Metori/mqtt_domofon/doc/mqtt_domofon_work_flow.jpg

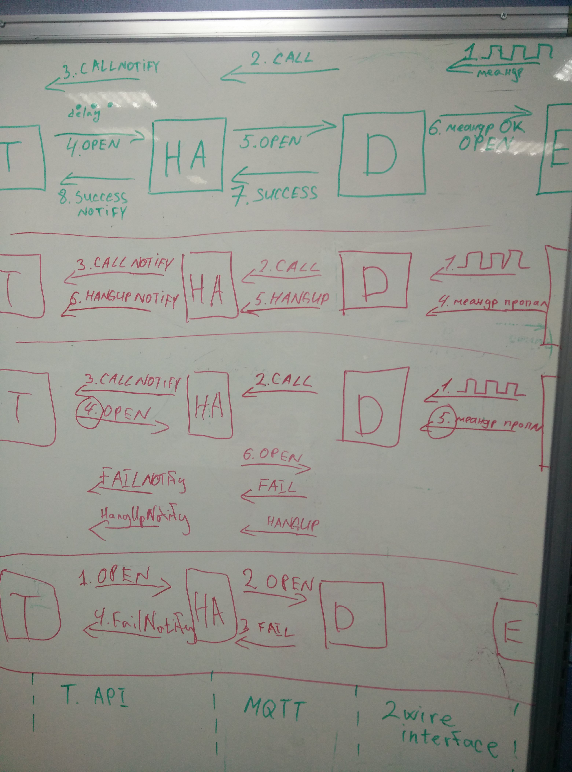
doc/mqtt_domofon_work_flow.jpg
