Metori/mqtt_domofon/doc/mqtt_domofon_complete_device.jpg

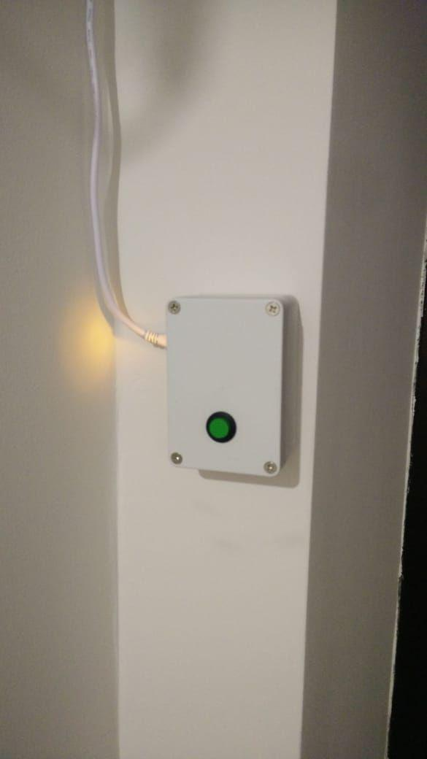
doc/mqtt_domofon_complete_device.jpg
