Metori/mqtt_domofon/doc/mqtt_domofon_circuit_diagram.jpg

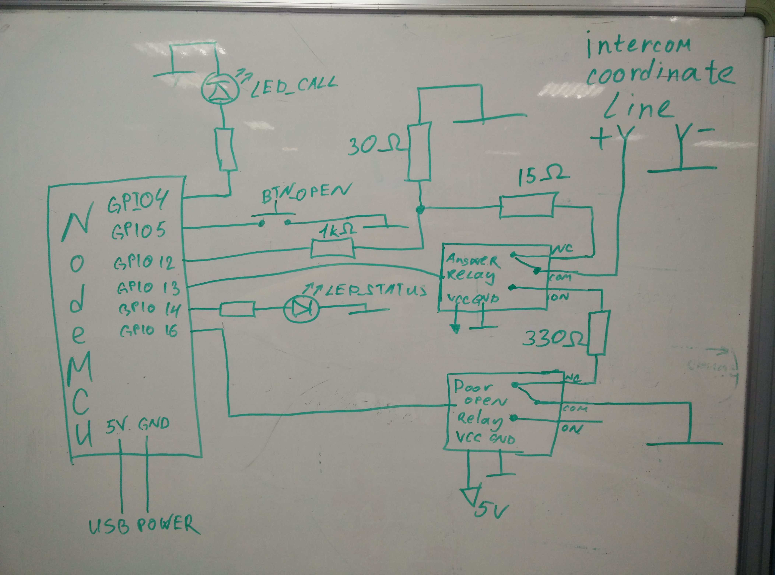
doc/mqtt_domofon_circuit_diagram.jpg
