Metori/mqtt_domofon/(commit log)

2018-07-28 Call button debouncing added; MQTT flow implemented; HW delays for domofon fine tuned; Other improvements;
2018-07-30 Circuit diagram, work flow diagram and complete device image added
2018-08-22 New button and new LED support added. Relay delay tuned.
2019-04-13 hex numbers replaced with chars
    [mqtt_domofon.ino]
